rocketscream/MiniUltraLoRaWAN/Enclosure/README.md

# Mini Ultra LoRaWAN Enclosure

A 3D printable enclosure has been created to house the Mini Ultra LoRaWAN device with pinheaders and battery holder installed.  The enclosure may need to be modified if additional hardware/sensors/etc have been mounted.  This has been tested with an SMA antenna mount on 868/915MHz devices.

Assembly of the enclosure will require qty 4 x 20mm socket cap head M2 screws and qty 4 x M2 nuts.

Two variations are available: one three-part model which includes a gasket to help seal the enclosure, and one that can print without a gasket suitable for indoor use.

## Weatherproof gasket

For maximum weather resistance when mounting outdoors, print the following files in PETG:

* [RocketScream_MiniUltraLoRaWAN_bottom.stl](RocketScream_MiniUltraLoRaWAN_bottom.stl)
* [RocketScream_MiniUltraLoRaWAN_top.stl](RocketScream_MiniUltraLoRaWAN_top.stl)

Print the gasket model in a flexible filament such as TPU:

* [RocketScream_MiniUltraLoRaWAN_gasket.stl](RocketScream_MiniUltraLoRaWAN_gasket.stl)

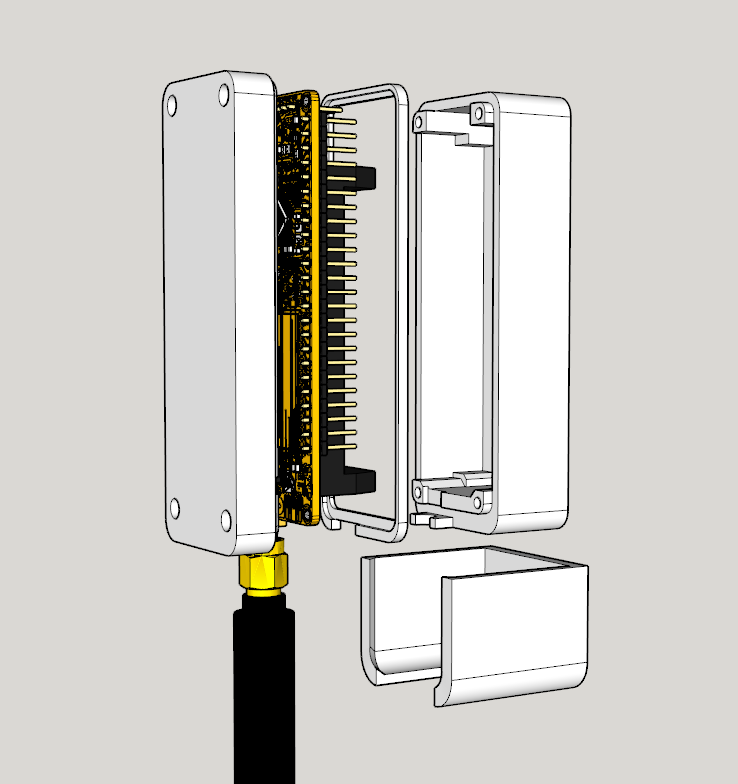
[picture p1: Enclosure/explosion_gasket.png]
Enclosure_with_gasket


## Indoor mounting

For mounting indoors, print the following files in PETG:

* [RocketScream_MiniUltraLoRaWAN_bottom_-_no_gasket.stl](RocketScream_MiniUltraLoRaWAN_bottom_-_no_gasket.stl)
* [RocketScream_MiniUltraLoRaWAN_top.stl](RocketScream_MiniUltraLoRaWAN_top.stl)

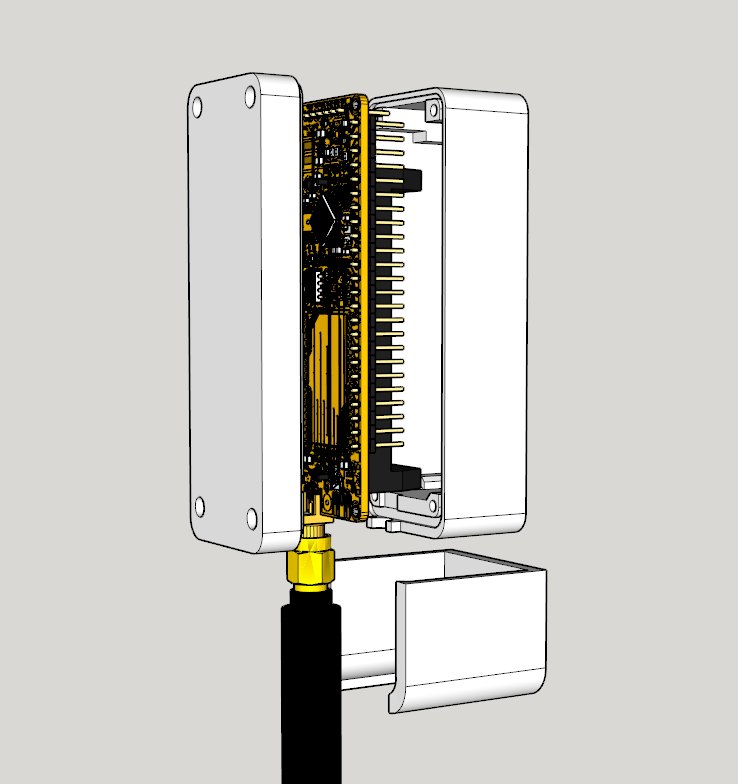
[picture p2: Enclosure/explosion_no_gasket.png]
Enclosure_without_gasket


## Mounting clip

A simple mounting clip is provided for easy mounting to a vertical surface.

* [RocketScream_MiniUltraLoRaWAN_mount.stl](RocketScream_MiniUltraLoRaWAN_mount.stl)

## Model source

The enclosure was created with SketchUp and can be modified using [SketchUp Free](https://www.sketchup.com/products/sketchup-free).

* [RocketScream_MiniUltraLoRaWAN.skp](RocketScream_MiniUltraLoRaWAN.skp)
