rocketscream/MiniUltraLoRaWAN/Enclosure/RocketScream_MiniUltraLoRaWAN_bottom.stl

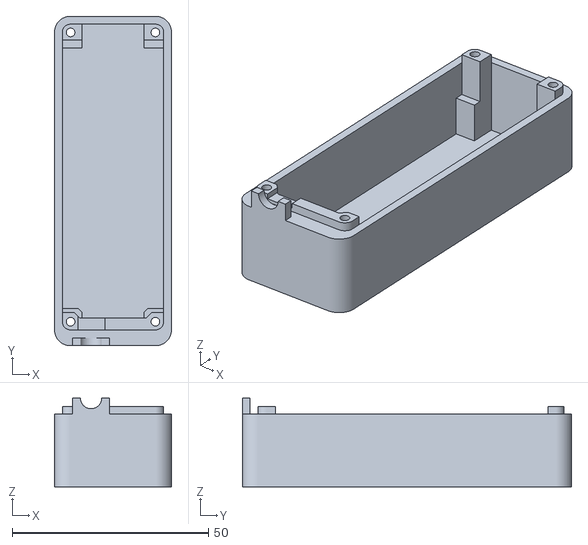
[picture p3: CAD file, 2018-09-05]
Enclosure/RocketScream_MiniUltraLoRaWAN_bottom.stl
29.8 x 83.9 x 22.6
