rocketscream/MiniUltraLoRaWAN/Enclosure/RocketScream_MiniUltraLoRaWAN_mount.stl

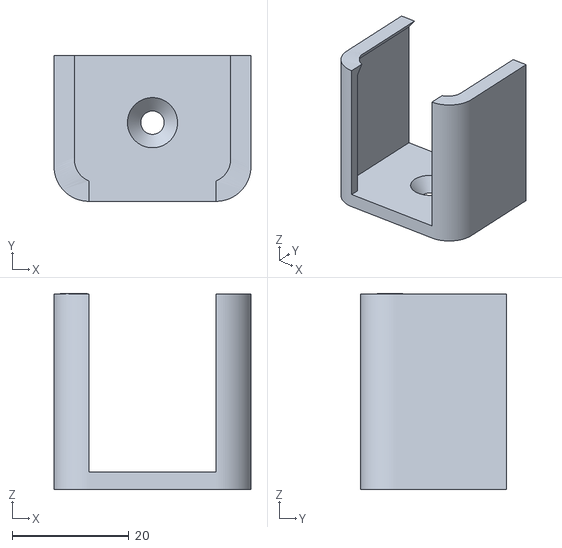
[picture p4: CAD file, 2018-09-05]
Enclosure/RocketScream_MiniUltraLoRaWAN_mount.stl
33.8 x 25.0 x 33.7
