rocketscream/MiniUltraLoRaWAN/Enclosure/RocketScream_MiniUltraLoRaWAN_top.stl

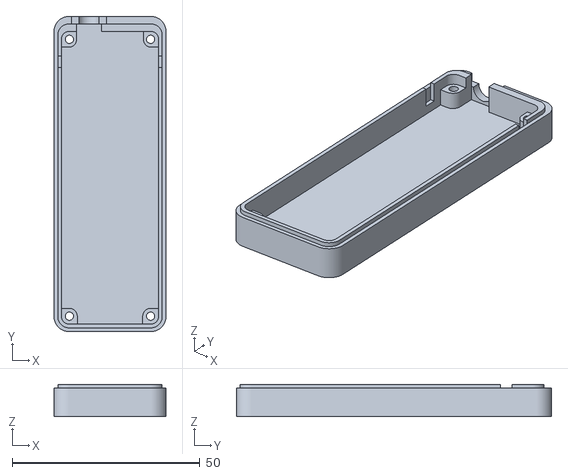
[picture p5: CAD file, 2018-09-04]
Enclosure/RocketScream_MiniUltraLoRaWAN_top.stl
29.8 x 83.9 x 8.60
