rocketscream/MiniUltraLoRaWAN/Enclosure/RocketScream_MiniUltraLoRaWAN_gasket.stl

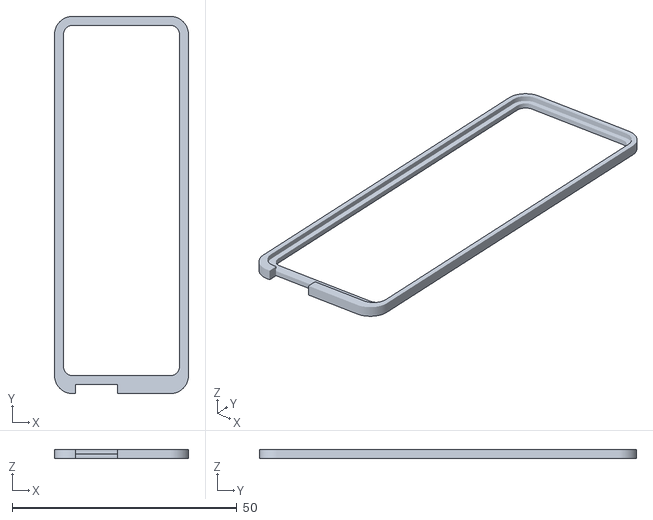
[picture p6: CAD file, 2018-09-04]
Enclosure/RocketScream_MiniUltraLoRaWAN_gasket.stl
29.8 x 83.9 x 2.00
