rocketscream/MiniUltraLoRaWAN/(list of files, cad)

Other CAD files:
Enclosure/RocketScream_MiniUltraLoRaWAN_bottom_-_no_gasket.stl
