rocketscream/MiniUltraLoRaWAN/MINI-ULTRA-LORAWAN.pdf

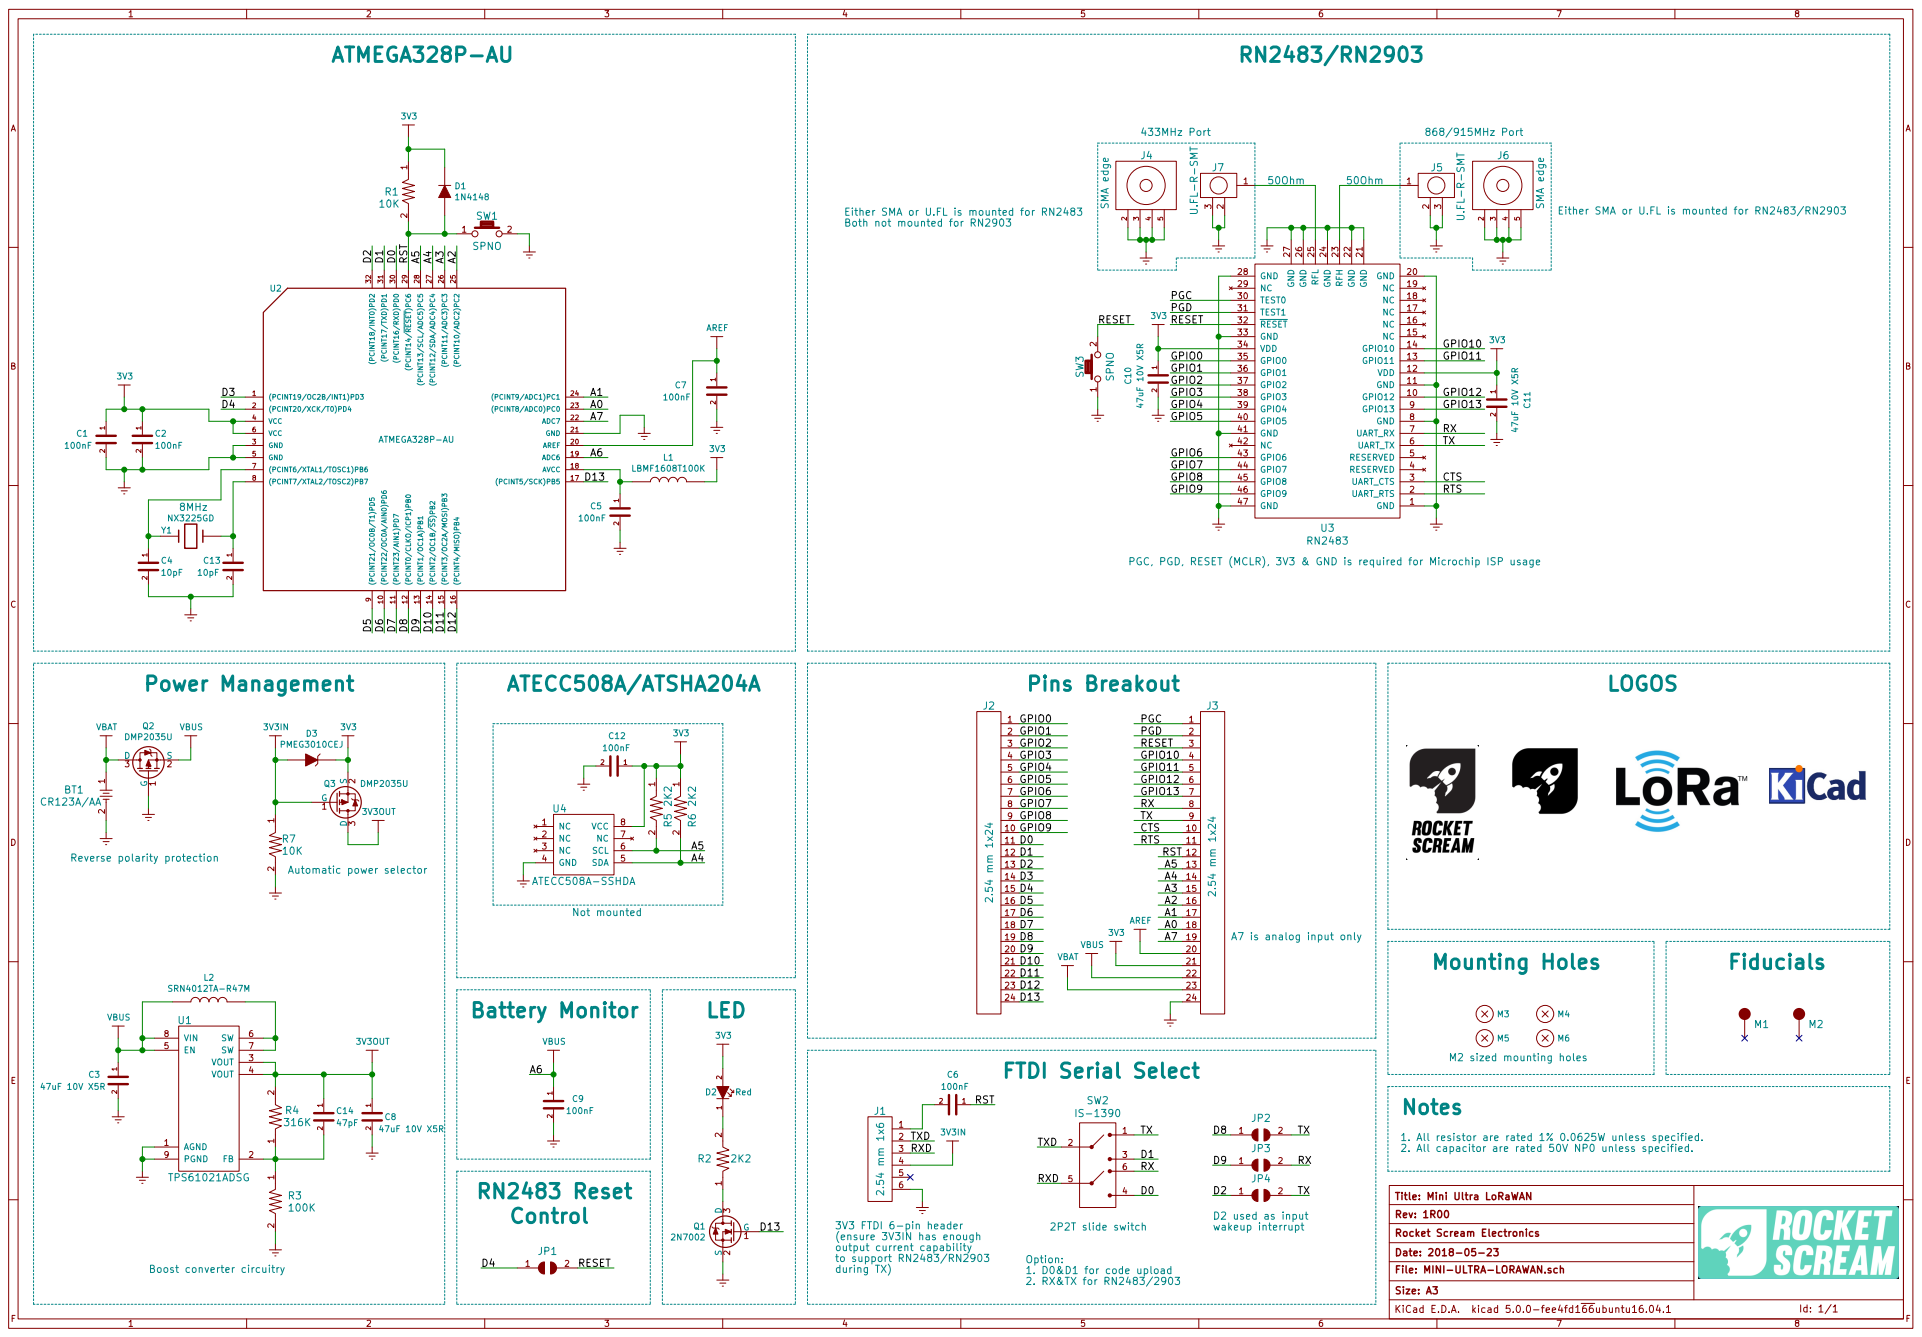
[picture p7: page 1]

PGC, PGD, RESET (MCLR), 3V3 & GND is required for Microchip ISP usage

A7 is analog input only

IS-1390 Option: 1. D0&D1 for code upload

1. All resistor are rated 1% 0.0625W unless specified. 2. All capacitor are rated 50V NP0 unless specified. G D13

Id: 1/1 Title: Mini Ultra LoRaWAN
F Date: 2018-05-23 KiCad E.D.A. kicad 5.0.0-fee4fd166ubuntu16.04.1 Rev: 1R00 Size: A3
File: MINI-ULTRA-LORAWAN.sch Rocket Scream Electronics

3V3 FTDI 6-pin header (ensure 3V3IN has enough output current capability
