rocketscream/MiniUltraLoRaWAN/MINI-ULTRA-LORAWAN.kicad_pcb

## KiCad design MINI-ULTRA-LORAWAN.kicad_pcb (2018-08-04)

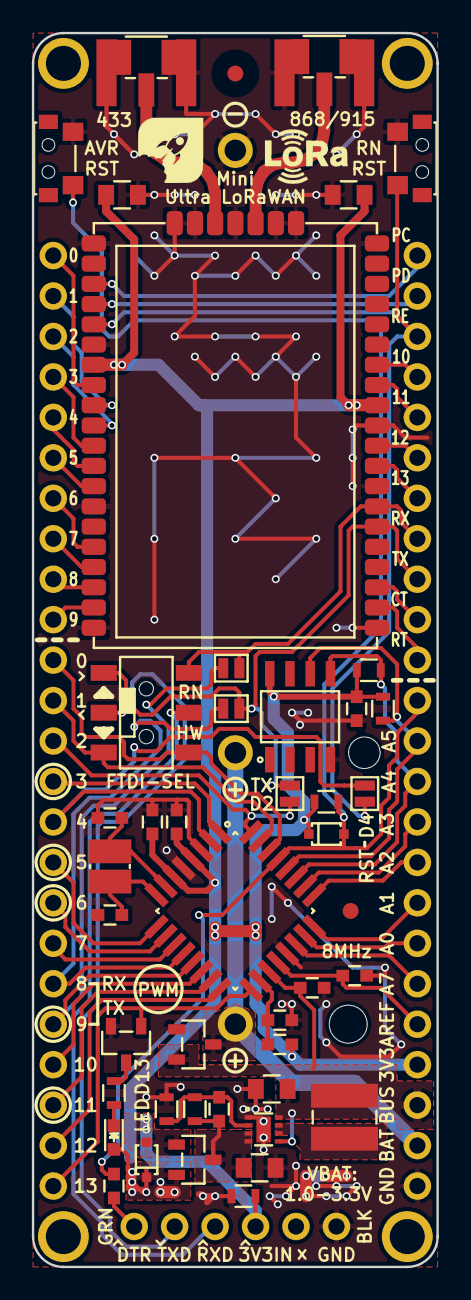
[picture p8: board MINI-ULTRA-LORAWAN.kicad_pcb from above]

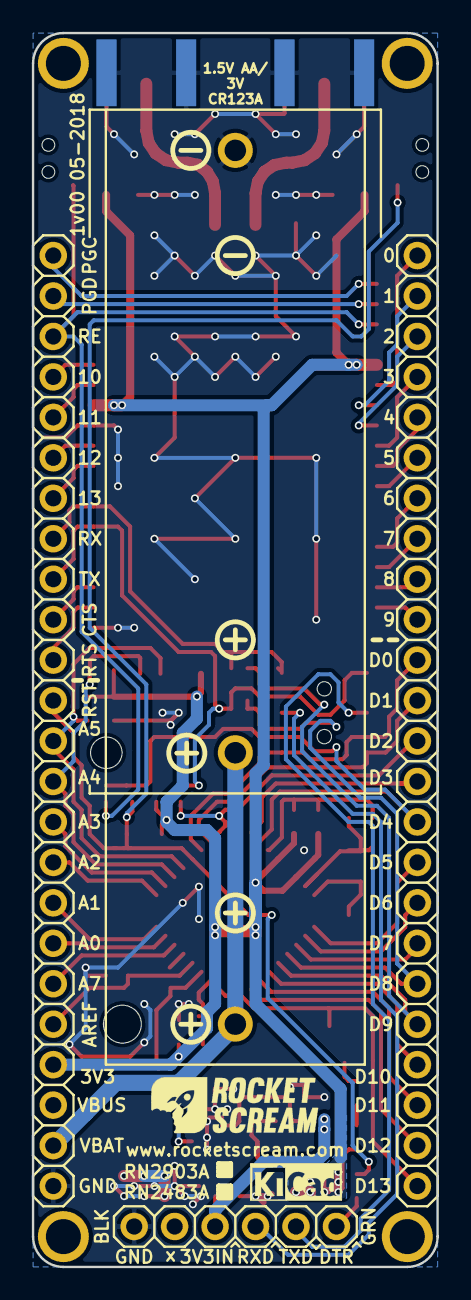
[picture p9: board MINI-ULTRA-LORAWAN.kicad_pcb from below]

Board: 2 copper layers, 25.4 x 77.5 mm, 59 parts (6 on the bottom side), 62 nets.

Parts:
BT1: CR123A/AA; 1028-1051
C1, C2, C5, C6, C7, C9, C12: 100nF; C_0603
C3, C8, C10, C11: 47uF 10V X5R; C_0805
C4, C13: 10pF; C_0603
C14: 47pF; C_0603
D1: 1N4148; SOD-323
D2: Red; LED_0603
D3: PMEG3010CEJ; SOD-323
J1: 2.54 mm 1x6; HDR_1x6_Pitch2.54mm
J2, J3: 2.54 mm 1x24; HDR_1x24_Pitch2.54mm
J4, J6: RF-SMA-EDGE_Without_Feed
J5, J7: U.FL-R-SMT; U.FL-R-SMT_Extended
JP1, JP2, JP3, JP4: JUMPER-1-WAY; JUMPER-1-WAY-SMD
L1: LBMF1608T100K; I_0603
L2: SRN4012TA-R47M; SRN4012TA
LOGO1: LOGO-KICAD; LOGO-KICAD_XXXSmall
LOGO2: LOGO-ROCKET-SCREAM; LOGO-ROCKET-SCREAM_Horizontal_XXSmall
LOGO3: LOGO-LORA; LOGO-LORA_XSmall
LOGO4: LOGO-ROCKET-SCREAM; LOGO-ROCKET-SCREAM_Without_Text_XXXSmall
M1, M2: FIDUCIAL; FIDUCIAL-1MM
M3, M4, M5, M6: MOUNT_HOLE; HOLE_PTH_2.2MM
Q1: 2N7002; SOT-23
Q2, Q3: DMP2035U; SOT-23
R1, R7: 10K; R_0603
R2, R5, R6: 2K2; R_0603
R3: 100K; R_0603
R4: 316K; R_0603
SW1, SW3: SPNO; TS-018
SW2: IS-1390
U1: TPS61021ADSG; WSON-8
U2: ATMEGA328P-AU; TQFP-32_7x7mm_Pitch0.8mm
U3: RN2483; RN2xx3
U4: ATECC508A-SSHDA; SOIC-8-N_8S1
Y1: NX3225GD

Connections:
3V3: C1.1, C2.1, C10.1, C11.1, C12.1, D1.1, D2.2, D3.1, J3.21, L1.2, Q3.2, R1.1, R5.1, R6.1, U2.4, U2.6, U3.12, U3.34, U4.8
3V3IN: D3.2, J1.4, Q3.1, R7.1
3V3OUT: C8.1, C14.1, Q3.3, R4.2, U1.3, U1.4
/A0: J3.18, U2.23
/A1: J3.17, U2.24
/A2: J3.16, U2.25
/A3: J3.15, U2.26
/A4: J3.14, R6.2, U2.27, U4.5
/A5: J3.13, R5.2, U2.28, U4.6
/A7: J3.19, U2.22
/CTS: J3.10, U3.3
/D0: J2.11, SW2.4, U2.30
/D1: J2.12, SW2.3, U2.31
/D2: J2.13, JP4.1, U2.32
/D3: J2.14, U2.1
/D4: J2.15, JP1.1, U2.2
/D5: J2.16, U2.9
/D6: J2.17, U2.10
/D7: J2.18, U2.11
/D8: J2.19, JP2.1, U2.12
/D9: J2.20, JP3.1, U2.13
/D10: J2.21, U2.14
/D11: J2.22, U2.15
/D12: J2.23, U2.16
/D13: J2.24, Q1.1, U2.17
/GPIO0: J2.1, U3.35
/GPIO1: J2.2, U3.36
/GPIO2: J2.3, U3.37
/GPIO3: J2.4, U3.38
/GPIO4: J2.5, U3.39
/GPIO5: J2.6, U3.40
/GPIO6: J2.7, U3.43
/GPIO7: J2.8, U3.44
/GPIO8: J2.9, U3.45
/GPIO9: J2.10, U3.46
/GPIO10: J3.4, U3.14
/GPIO11: J3.5, U3.13
/GPIO12: J3.6, U3.10
/GPIO13: J3.7, U3.9
/PGC: J3.1, U3.30
/PGD: J3.2, U3.31
/RESET: J3.3, JP1.2, SW3.2, U3.32
/RST: C6.1, D1.2, J3.12, R1.2, SW1.1, U2.29
/RTS: J3.11, U3.2
/RX: J3.8, JP3.2, SW2.6, U3.7
/RXD: J1.3, SW2.5
/TX: J3.9, JP2.2, JP4.2, SW2.1, U3.6
/TXD: J1.2, SW2.2
AREF: C7.1, J3.20, U2.20
GND: BT1.2, C1.2, C2.2, C3.2, C4.2, C5.2, C7.2, C8.2, C9.2, C10.2, C11.2, C12.2, C13.2, J1.6, J3.24, J4.2, J4.3, J4.4, J4.5, J5.2, J5.3, J6.2, J6.3, J6.4, J6.5, J7.2, J7.3, Q1.2, Q2.1, R3.2, R7.2, SW1.2, SW3.1, U1.1, U1.9, U2.3, U2.5, U2.21, U3.1, U3.8, U3.11, U3.20, U3.21, U3.22, U3.24, U3.26, U3.27, U3.28, U3.33, U3.41, U3.47, U4.4
unnamed: C4.1, U2.7, Y1.1
unnamed: C5.1, L1.1, U2.18
unnamed: C6.2, J1.1
unnamed: C13.1, U2.8, Y1.2
unnamed: C14.2, R3.1, R4.1, U1.2
unnamed: D2.1, R2.2
unnamed: J5.1, U3.23
unnamed: J7.1, U3.25
unnamed: L2.2, U1.6, U1.7
unnamed: Q1.3, R2.1
VBAT: BT1.1, J3.23, Q2.3
VBUS: C3.1, C9.1, J3.22, L2.1, Q2.2, U1.5, U1.8, U2.19
